UofI-CDACS/Robot_hand/(list of files, cad)

Other CAD files:
HandBase V-Spring-2021.f3d
