UofI-CDACS/Robot_hand/calibrated servo example.xlsx

Feather M0 1 | Closing |  |  |  |  |  |  |  |  |  |  |  | Feather M0 1 | Opening
Pulses | Command | Thumb A0 | Index A1 | Middle A2 | Ring A3 | Pinky A4 | Error |  |  |  |  |  | Pulses | Command | Thumb A0 | Index A1 | Middle A2 | Ring A3 | Pinky A4
1 | 150 | 147 | 148 | 135 | 150 | 149 | -2.00% | -1.33% | -10.00% | 0.00% | -0.67% |  | 1 | 440 | 434 | 428 | 432 | 434 | 442 | -1.36% | -2.73% | -1.82% | -1.36% | 0.45%
2 | 151 | 147 | 148 | 148 | 151 | 149 | -2.65% | -1.99% | -1.99% | 0.00% | -1.32% |  | 2 | 439 | 434 | 430 | 432 | 439 | 451 | -1.14% | -2.05% | -1.59% | 0.00% | 2.73%
3 | 152 | 148 | 154 | 149 | 152 | 150 | -2.63% | 1.32% | -1.97% | 0.00% | -1.32% |  | 3 | 438 | 434 | 429 | 432 | 433 | 443 | -0.91% | -2.05% | -1.37% | -1.14% | 1.14%
4 | 153 | 151 | 147 | 149 | 151 | 150 | -1.31% | -3.92% | -2.61% | -1.31% | -1.96% |  | 4 | 437 | 435 | 427 | 432 | 434 | 440 | -0.46% | -2.29% | -1.14% | -0.69% | 0.69%
5 | 154 | 147 | 146 | 146 | 150 | 151 | -4.55% | -5.19% | -5.19% | -2.60% | -1.95% |  | 5 | 436 | 435 | 426 | 433 | 433 | 440 | -0.23% | -2.29% | -0.69% | -0.69% | 0.92%
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
