UofI-CDACS/Robot_hand/calibration example.xlsx

Sheet: calibrationm01
Closing Hand
Pulse | Thumb A0 | Index A1 | Middle A2 | Ring A3 | Pinky A4
150 | 284 | 283 | 283 | 289 | 280
151 | 286 | 282 | 283 | 288 | 282
152 | 283 | 284 | 283 | 290 | 279
153 | 286 | 284 | 287 | 289 | 281
154 | 286 | 286 | 289 | 289 | 283
155 | 299 | 306 | 304 | 303 | 297
156 | 290 | 288 | 291 | 291 | 286
157 | 292 | 291 | 295 | 294 | 288
158 | 295 | 295 | 294 | 296 | 288
159 | 299 | 296 | 296 | 300 | 291
160 | 303 | 298 | 297 | 301 | 294
161 | 302 | 304 | 301 | 303 | 297
162 | 306 | 306 | 306 | 308 | 305
163 | 305 | 306 | 304 | 308 | 301
164 | 305 | 306 | 308 | 309 | 305
165 | 306 | 307 | 306 | 310 | 308
166 | 306 | 309 | 308 | 314 | 309
167 | 310 | 310 | 312 | 315 | 309
168 | 314 | 313 | 315 | 317 | 310
169 | 314 | 314 | 317 | 322 | 312
170 | 317 | 315 | 316 | 322 | 312
171 | 319 | 322 | 318 | 323 | 310
172 | 333 | 333 | 321 | 336 | 326
173 | 323 | 324 | 323 | 325 | 318
174 | 325 | 326 | 324 | 324 | 316
175 | 329 | 329 | 325 | 324 | 320
176 | 331 | 330 | 329 | 337 | 323
177 | 331 | 331 | 330 | 332 | 325
178 | 329 | 332 | 333 | 332 | 328
179 | 340 | 346 | 338 | 346 | 331
180 | 332 | 335 | 337 | 335 | 332
181 | 333 | 334 | 337 | 343 | 332
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
